HMGrunthos/IsolatedPowerControl/ConnectionPhotos/IMG_20181013_072904.jpg

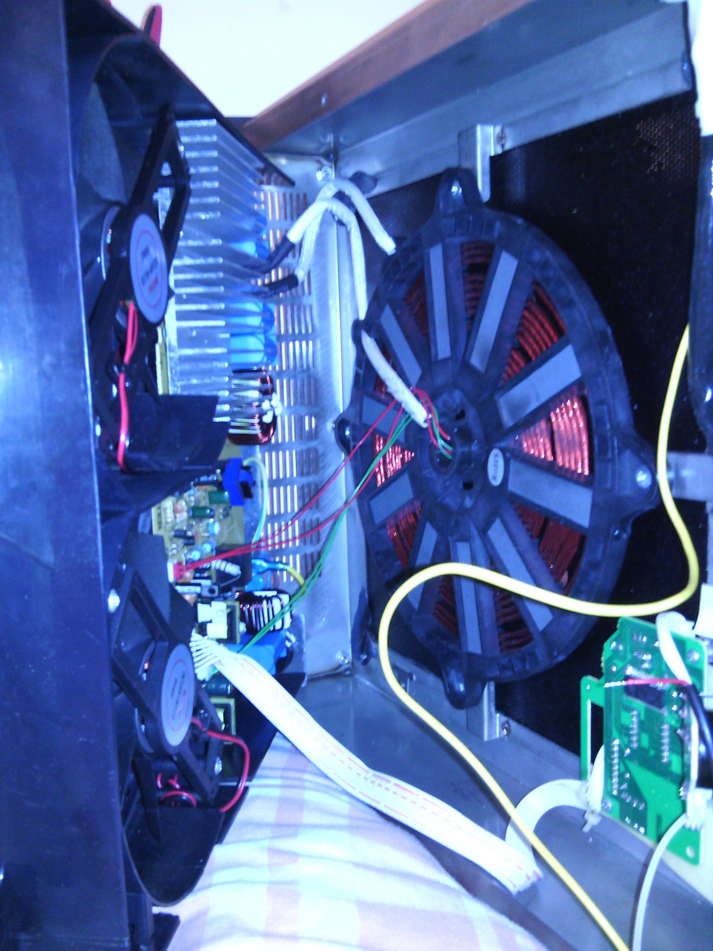
ConnectionPhotos/IMG_20181013_072904.jpg
