HMGrunthos/IsolatedPowerControl/ConnectionPhotos/IMG_20180810_202949.jpg

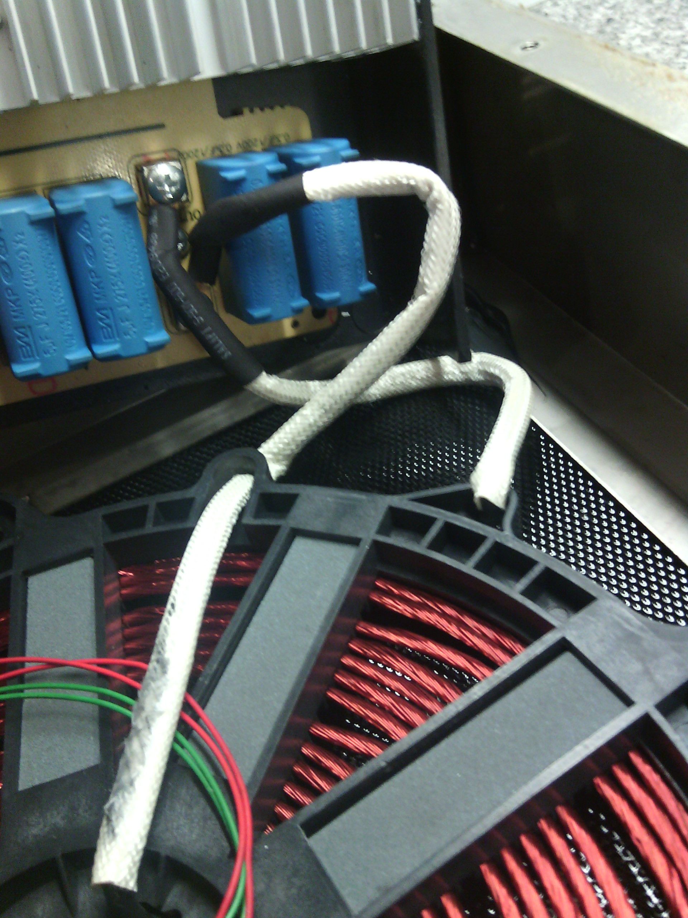
ConnectionPhotos/IMG_20180810_202949.jpg
