HMGrunthos/IsolatedPowerControl/ConnectionPhotos/IMG_20180810_202757.jpg

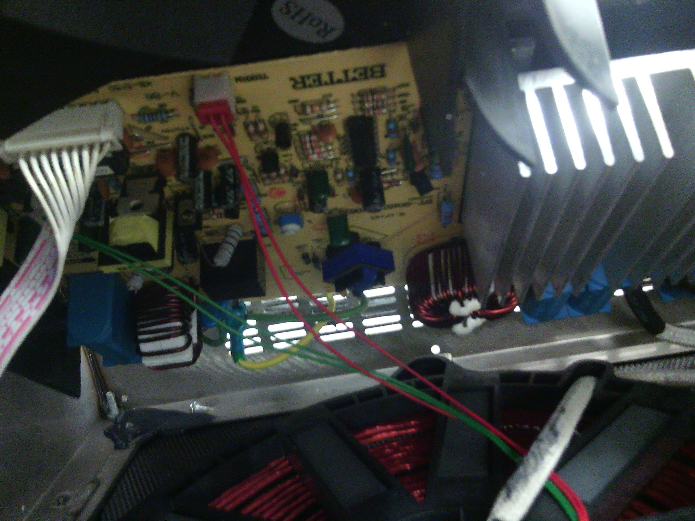
ConnectionPhotos/IMG_20180810_202757.jpg
