HMGrunthos/IsolatedPowerControl/ConnectionPhotos/IMG_20180810_202901.jpg

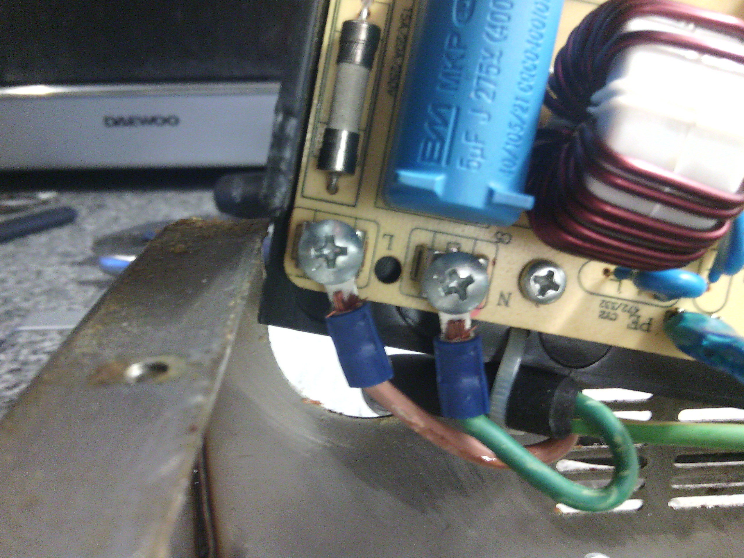
ConnectionPhotos/IMG_20180810_202901.jpg
