HMGrunthos/IsolatedPowerControl/ConnectionPhotos/IMG_20180810_203640.jpg

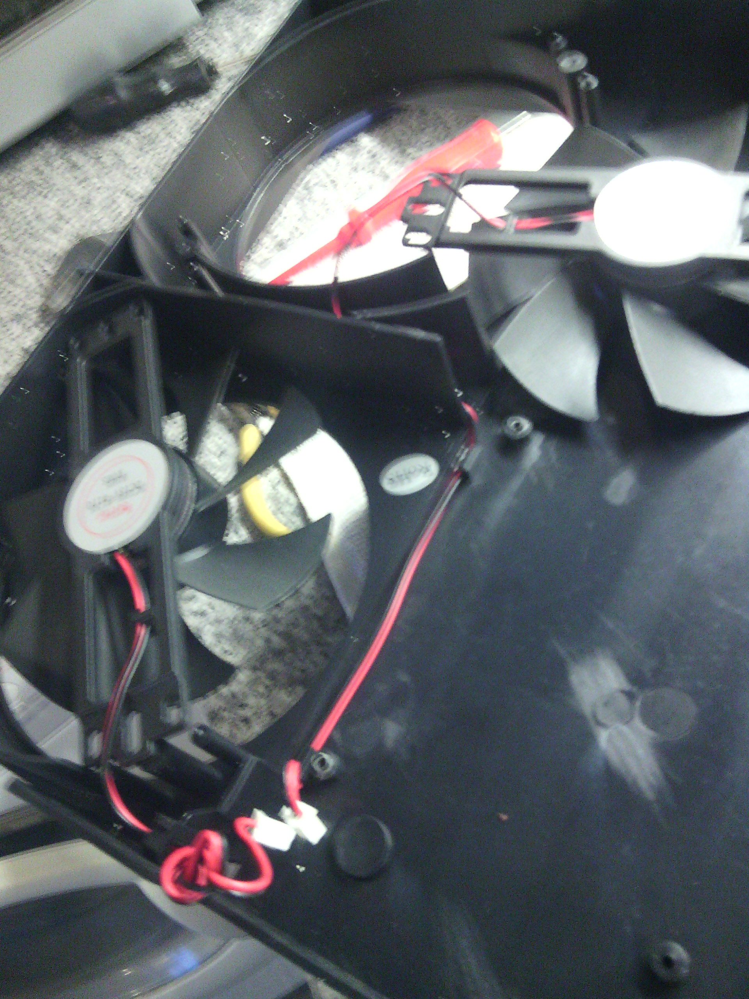
ConnectionPhotos/IMG_20180810_203640.jpg
