HMGrunthos/IsolatedPowerControl/ConnectionPhotos/IMG_20180810_205737.jpg

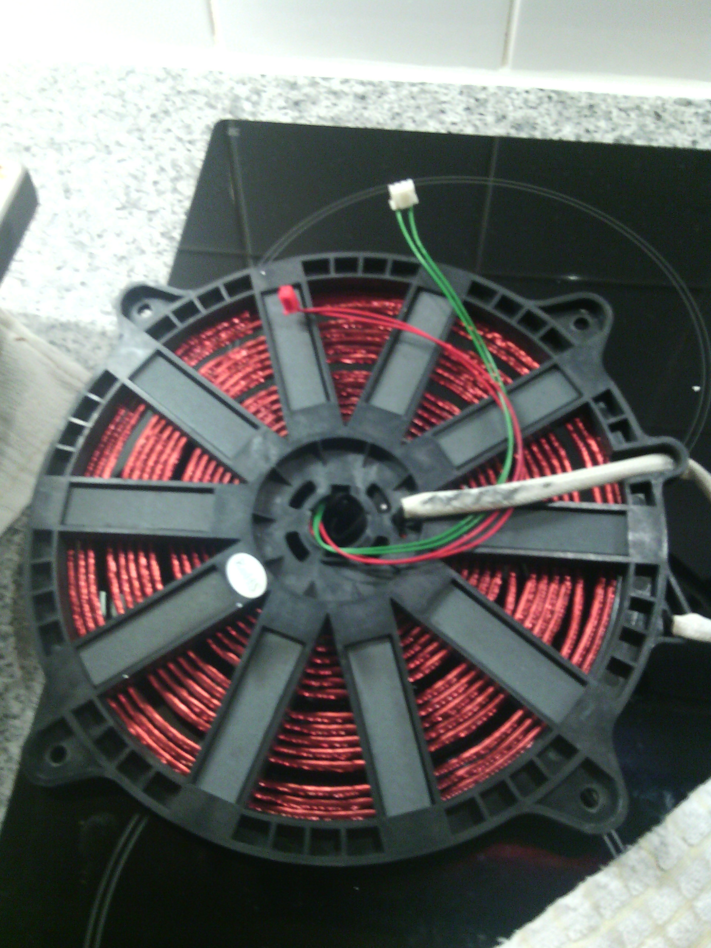
ConnectionPhotos/IMG_20180810_205737.jpg
