HMGrunthos/IsolatedPowerControl/ConnectionPhotos/IMG_20181003_012516.jpg

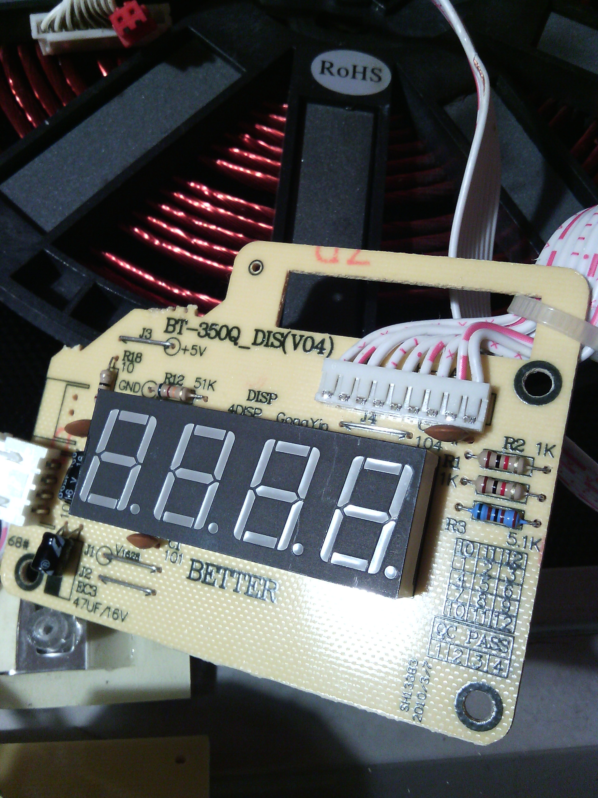
ConnectionPhotos/IMG_20181003_012516.jpg
