HMGrunthos/IsolatedPowerControl/ConnectionPhotos/IMG_20181013_070857.jpg

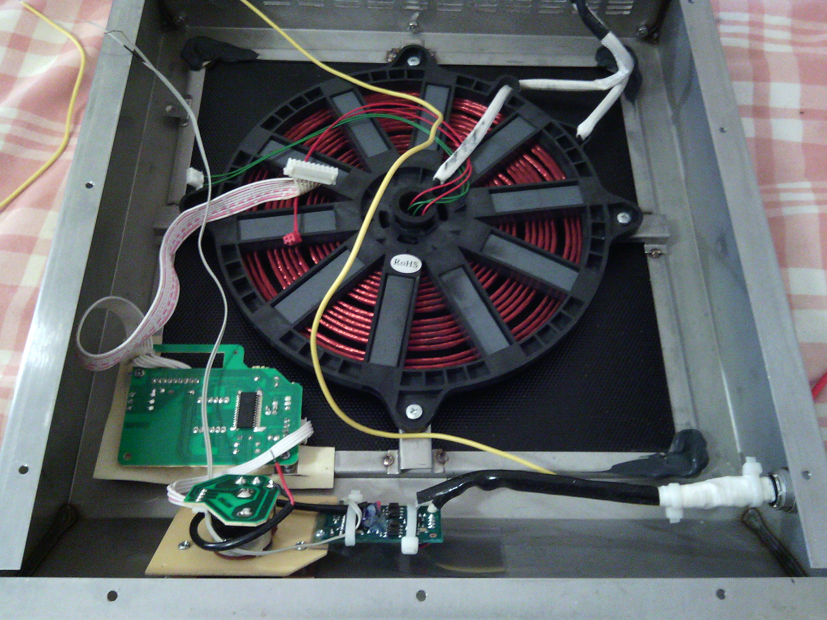
ConnectionPhotos/IMG_20181013_070857.jpg
