HMGrunthos/IsolatedPowerControl/ConnectionPhotos/IMG_20181013_071108.jpg

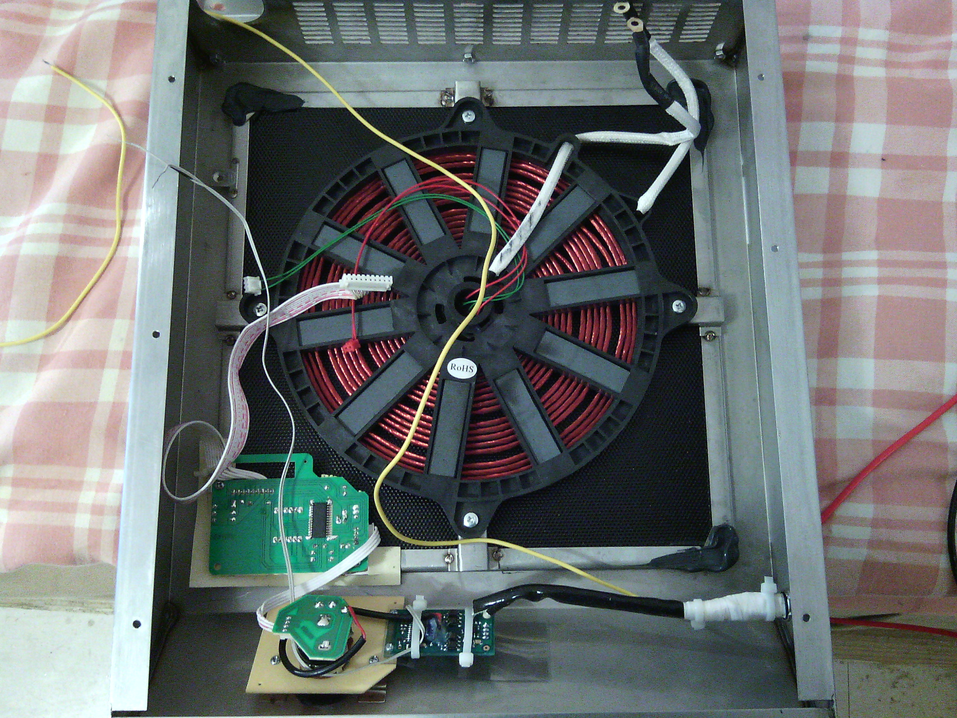
ConnectionPhotos/IMG_20181013_071108.jpg
