HMGrunthos/IsolatedPowerControl/ConnectionPhotos/IMG_20181019_042100.jpg

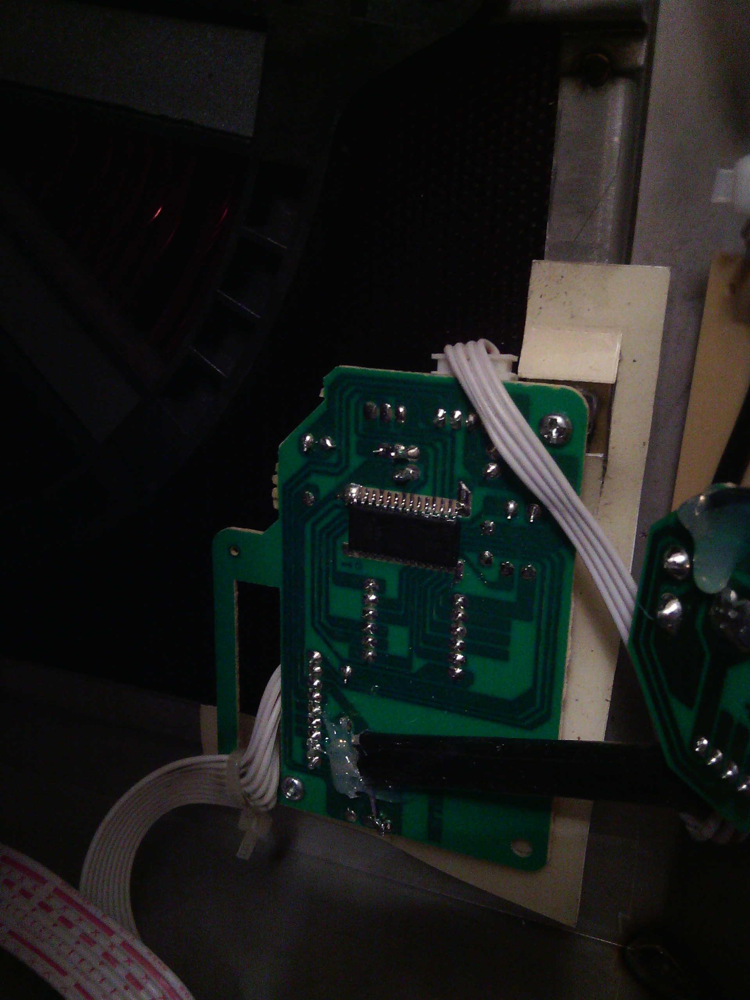
ConnectionPhotos/IMG_20181019_042100.jpg
