HMGrunthos/IsolatedPowerControl/IsolatedPowerControlBottomCopper.pdf

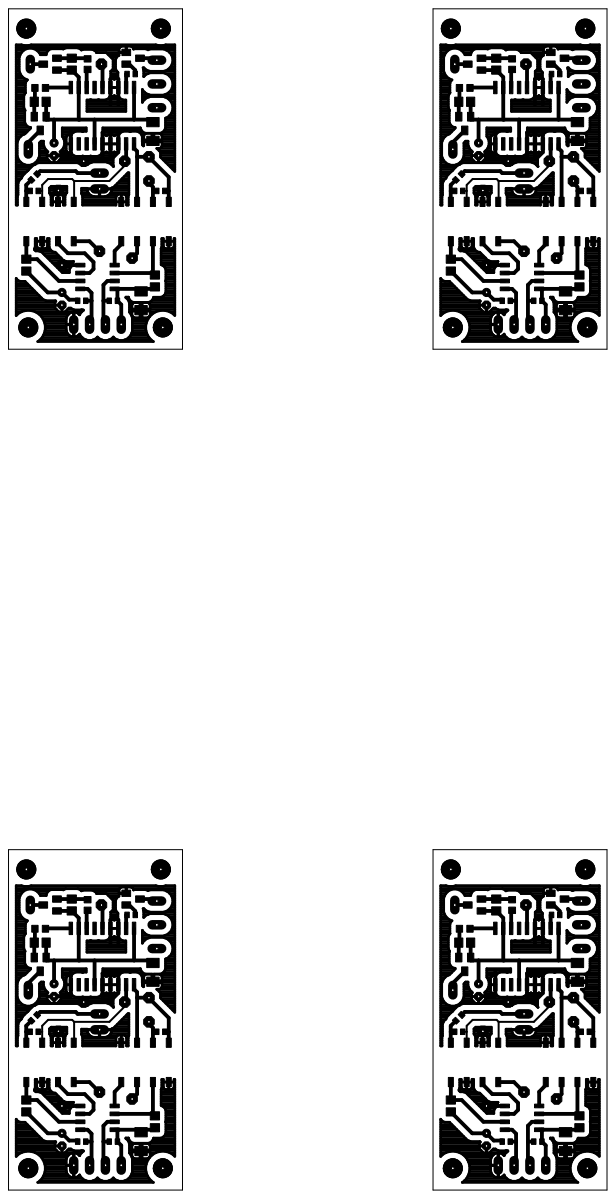
[picture p11: page 1]
