HMGrunthos/IsolatedPowerControl/IsolatedPowerControlBottomMask.pdf

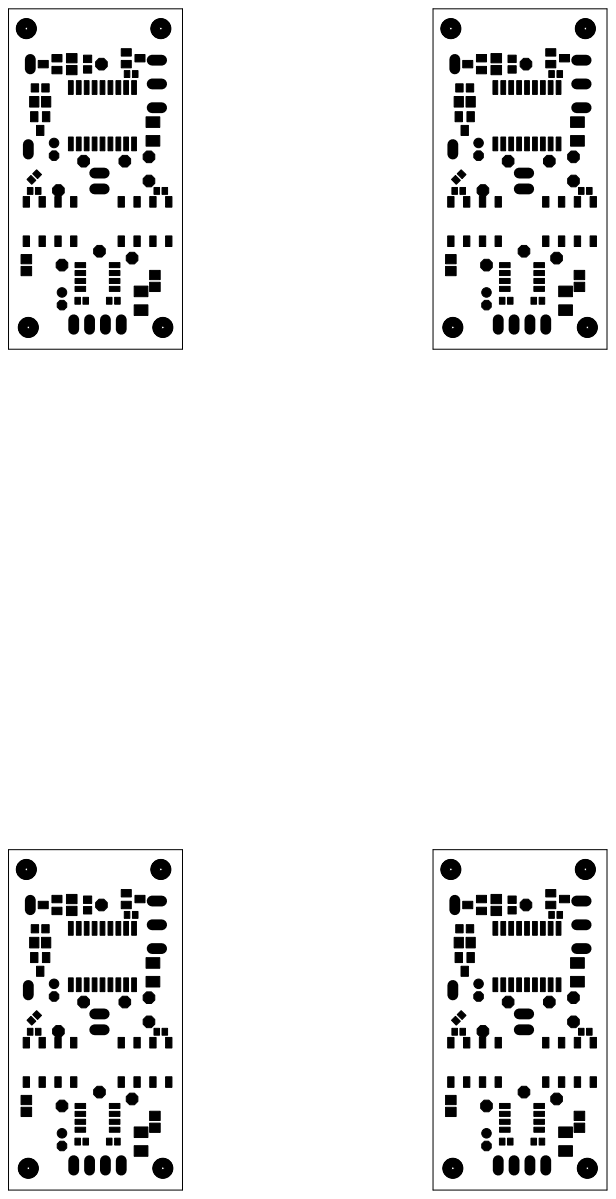
[picture p12: page 1]
