HMGrunthos/IsolatedPowerControl/IsolatedPowerControlTopCopper.pdf

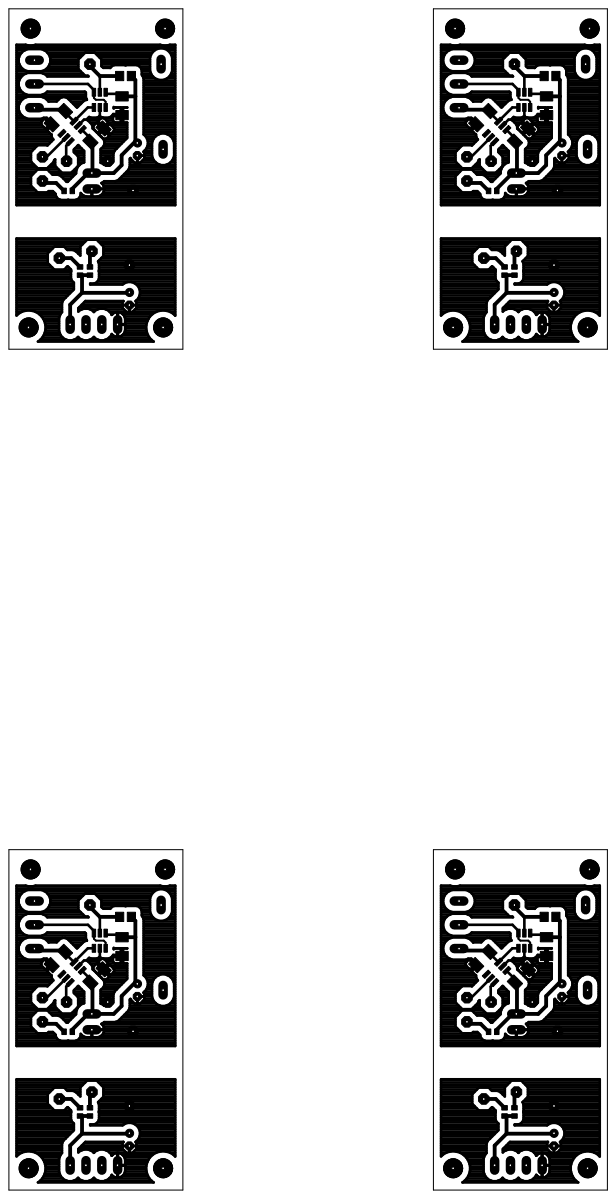
[picture p13: page 1]
