HMGrunthos/IsolatedPowerControl/IsolatedPowerControlTopMask.pdf

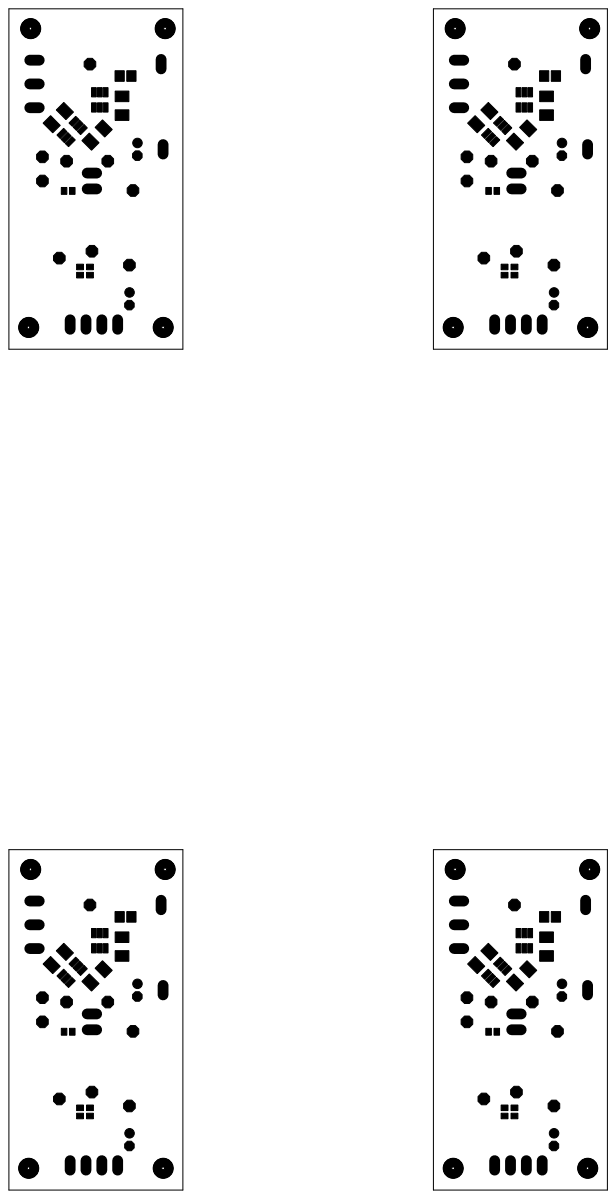
[picture p14: page 1]
