HMGrunthos/IsolatedPowerControl/IsolatedPowerControl.brd

## EAGLE design IsolatedPowerControl.brd (2018-10-14)

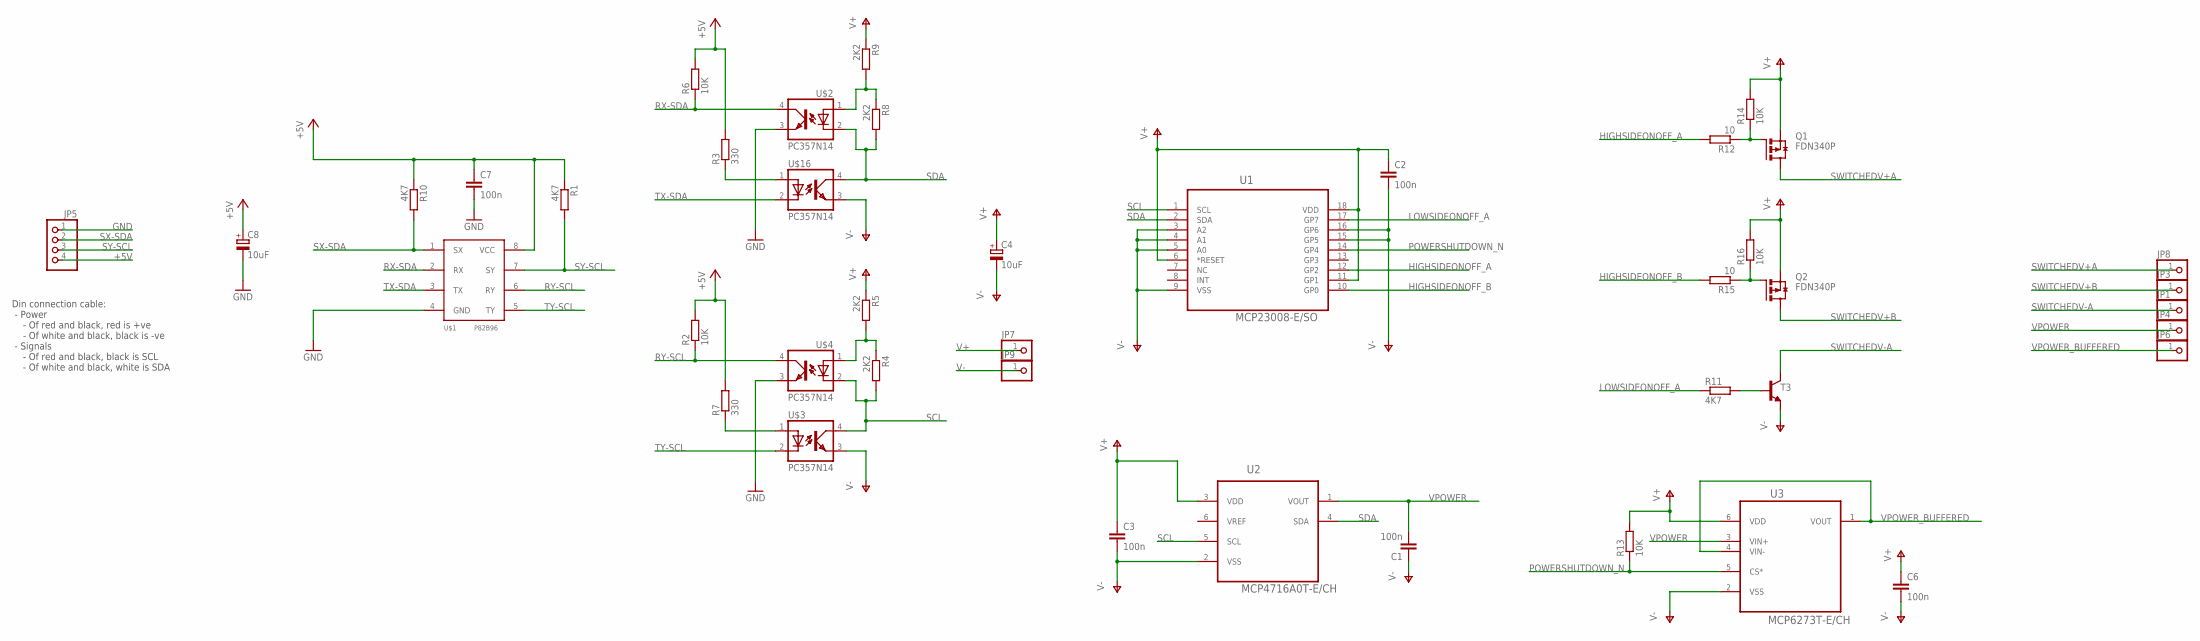
[picture p15: schematic IsolatedPowerControl.sch]

Parts:
C1, C2, C3, C6, C7: 100n; C1206K
C4, C8: 10uF; E2-5
JP1, JP3, JP4, JP6, JP7, JP8, JP9: PINHD-1X1LARGEPAD; 1X01-LARGEPAD
JP5: PINHD-1X4; 1X04
Q1, Q2: FDN340P; SUPER-SOT3
R1, R10, R11: 4K7; R0402
R2, R6, R13, R14, R16: 10K; R0805
R3, R7: 330; R0402
R4, R5, R8, R9: 2K2; R0402
R12, R15: 10; R0603
T3: MMBTA42LT1-NPN-SOT23-BEC; SOT23-BEC
U1: MCP23008-E/SO; SOIC127P1030X265-18N
U2: MCP4716A0T-E/CH; SOT95P270X145-6N
U3: MCP6273T-E/CH; SOT95P280X145-6N
U$1: P82B96; SOIC8
U$2, U$3, U$4, U$16: PC357N14; MINI-FLAT-4-DS

Connections:
+5V: C7.1, C8.+, JP5.4, R1.1, R2.2, R3.2, R6.2, R7.2, R10.1, U$1.8 (VCC)
GND: C7.2, C8.-, JP5.1, U$1.4 (GND), U$2.3 (EMIT), U$4.3 (EMIT)
HIGHSIDEONOFF_A: R12.2, U1.12 (GP2)
HIGHSIDEONOFF_B: R15.2, U1.10 (GP0)
LOWSIDEONOFF_A: R11.1, U1.17 (GP7)
unnamed: R3.1, U$16.1 (A)
unnamed: R8.1, R9.2, U$2.1 (A)
unnamed: R7.1, U$3.1 (A)
unnamed: R4.1, R5.2, U$4.1 (A)
unnamed: R11.2, T3.B
unnamed: Q2.1 (G), R15.1, R16.1
unnamed: Q1.1 (G), R12.1, R14.1
POWERSHUTDOWN_N: R13.1, U1.14 (GP4), U3.5 (CS*)
RX-SDA: R6.1, U$1.2 (RX), U$2.4 (COL)
RY-SCL: R2.1, U$1.6 (RY), U$4.4 (COL)
SCL: R4.2, U1.1 (SCL), U2.5 (SCL), U$3.4 (COL), U$4.2 (C)
SDA: R8.2, U1.2 (SDA), U2.4 (SDA), U$2.2 (C), U$16.4 (COL)
SWITCHEDV+A: JP8.1, Q1.3 (D)
SWITCHEDV+B: JP3.1, Q2.3 (D)
SWITCHEDV-A: JP1.1, T3.C
SX-SDA: JP5.2, R10.2, U$1.1 (SX)
SY-SCL: JP5.3, R1.2, U$1.7 (SY)
TX-SDA: U$1.3 (TX), U$16.2 (C)
TY-SCL: U$1.5 (TY), U$3.2 (C)
V+: C2.1, C3.1, C4.+, C6.1, JP7.1, Q1.2 (S), Q2.2 (S), R5.1, R9.1, R13.2, R14.2, R16.2, U1.6 (*RESET), U1.11 (GP1), U1.18 (VDD), U2.3 (VDD), U3.6 (VDD)
V-: C1.1, C2.2, C3.2, C4.-, C6.2, JP9.1, T3.E, U1.3 (A2), U1.4 (A1), U1.5 (A0), U1.9 (VSS), U1.15 (GP5), U1.16 (GP6), U2.2 (VSS), U3.2 (VSS), U$3.3 (EMIT), U$16.3 (EMIT)
VPOWER: C1.2, JP4.1, U2.1 (VOUT), U3.3 (VIN+)
VPOWER_BUFFERED: JP6.1, U3.1 (VOUT), U3.4 (VIN-)

Notes on the sheet:
Din connection cable: - Power - Of red and black, red is +ve - Of white and black, black is -ve - Signals - Of red and black, black is SCL - Of white and black, white is SDA

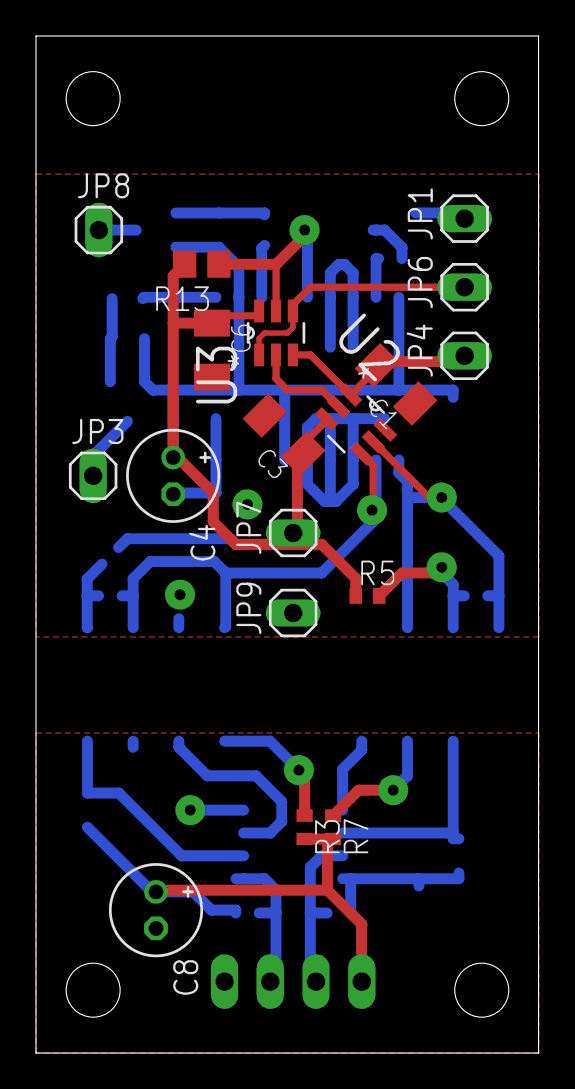
[picture p16: board IsolatedPowerControl.brd from above]

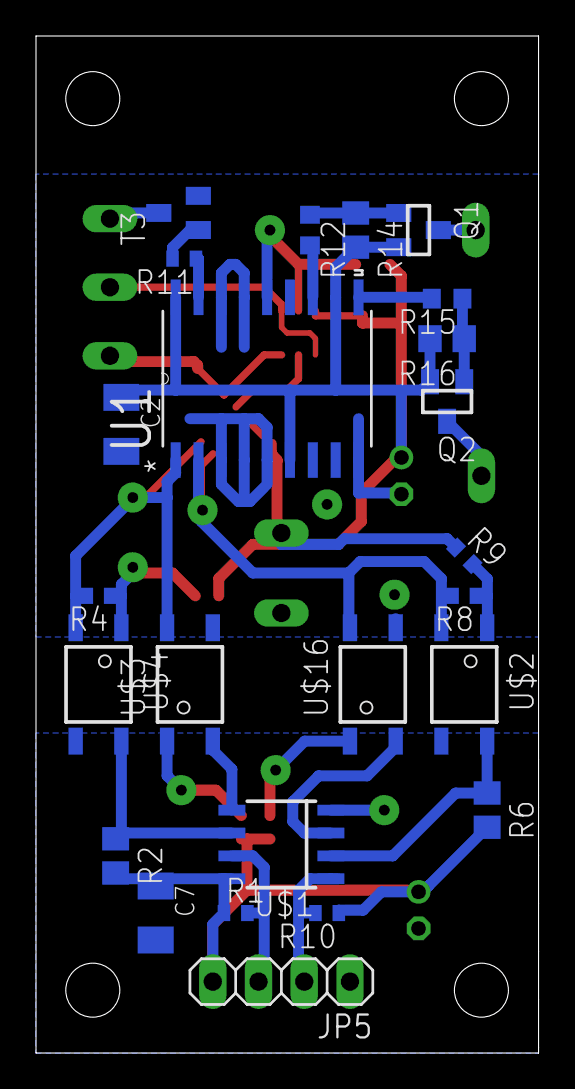
[picture p17: board IsolatedPowerControl.brd from below]

Board: 2 copper layers, 27.9 x 56.5 mm, 42 parts (24 on the bottom side), 28 nets.
