HMGrunthos/IsolatedPowerControl/(commit log)

2018-10-03 Initial checkin
    [IsolatedPowerControl.brd, IsolatedPowerControl.sch]
2018-10-03 Initial fit (incomplete routing)
    [IsolatedPowerControl.brd, IsolatedPowerControl.sch]
2018-10-04 First layout complete and checked
    [IsolatedPowerControl.brd, IsolatedPowerControl.sch]
2018-10-04 Added op amp with enable/power down (MCP6273T) and re-routed.
    [IsolatedPowerControl.brd, IsolatedPowerControl.sch]
2018-10-05 Added another isolated aux channel
    [IsolatedPowerControl.brd, IsolatedPowerControl.sch]
2018-10-05 Another reroute!
    [IsolatedPowerControl.brd, IsolatedPowerControl.sch]
2018-10-05 Increased track width
    [IsolatedPowerControl.brd]
2018-10-06 Tweaks following etching to open up clearances
    [IsolatedPowerControl.brd, IsolatedPowerControl.sch]
2018-10-08 Added test software
    [IsolatedPowerControl.brd, IsolatedPowerControl.sch]
2018-10-11 Added documentation to schematic. Added STM32 test sketch
    [IsolatedPowerControl.brd, IsolatedPowerControl.sch]
2018-10-11 Fixed an error in the cable colour note
    [IsolatedPowerControl.sch]
2018-10-13 Tested the control board with the cooker. It works!
2018-10-13 Added STM32 variant for the ETARM-STAMP-STM32 and ported over the cooker control sketch
2018-10-14 Minor tweaks to the layout to line things up
    [IsolatedPowerControl.brd]
2018-10-19 Added sketch that measures and displays temperatures using PT100 probes (just calibrated at 0C tripple point)
2018-10-23 Added sketch to both read temperature and controll the cooker (tested, no link between the two.)
2018-10-23 Added simple IIR filter to temperature channels
2018-10-26 Fixed the flickering vfd. Made the RTD read at 50Hz. Added LED power level indication.
    [TemperatureController.ino]
2018-10-27 Added alpha beta filter to the temperature measurements. Still to do (apart from lots of tidying), fix missed temperature readings (while communicating with the hob controller) - look into interrupts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
    [AlphaBetaFilterModel.ods]
2018-10-27 Added interrupt to sense new readings from the RTD interface. Added ring buffer to communicate from interrupt to main loop. Moved PID computation into cooker control function. Had a look at ferrites,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
    [TemperatureController.ino]
2018-10-27 Added in configuration for GPIO drive strength on the I2C lines
2018-10-28 Fixed the gpio programming to limit the slew rate - sadly it doesn't seem to work on I2C configured pins.
    [TemperatureController.ino]
2018-10-29 Added watchdog (and a pin that signals reset.) Added code to recover I2C clock settings when the I2C transaction fails.
    [TemperatureController.ino]
2018-10-29 Added minor comment and disabled power control.
2018-10-30 Switched the I2C2 cooker control over to software i2c control, this seems to have resolved the hangup. Made the power level a bit more linear.
    [TemperatureController.ino]
2018-11-01 Fixed a bug with string parsing (insufficient space for null terminator.) Introduced rolling display. Hacked in connection tester to run overnight.
    [TemperatureController.ino]
2018-11-01 Added photos of the internals of the CE208. Also includes photos of the interface board and it's connections to the hob.
